danielodicho/NTNUBUOY/README.md

# NTNUBUOY
Winner of the National NTNU contest: The Young Marine Scientist
Source code for the BUOY that can track GPS coordinates, along with other sensory information such as temperature, humidity, and pressure.
